degiy/stm32wb55_linky/design/adc_int.PNG

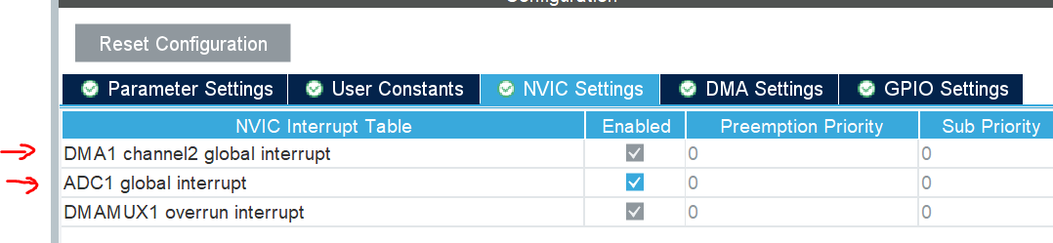
design/adc_int.PNG
