degiy/stm32wb55_linky/design/adc_settings.PNG

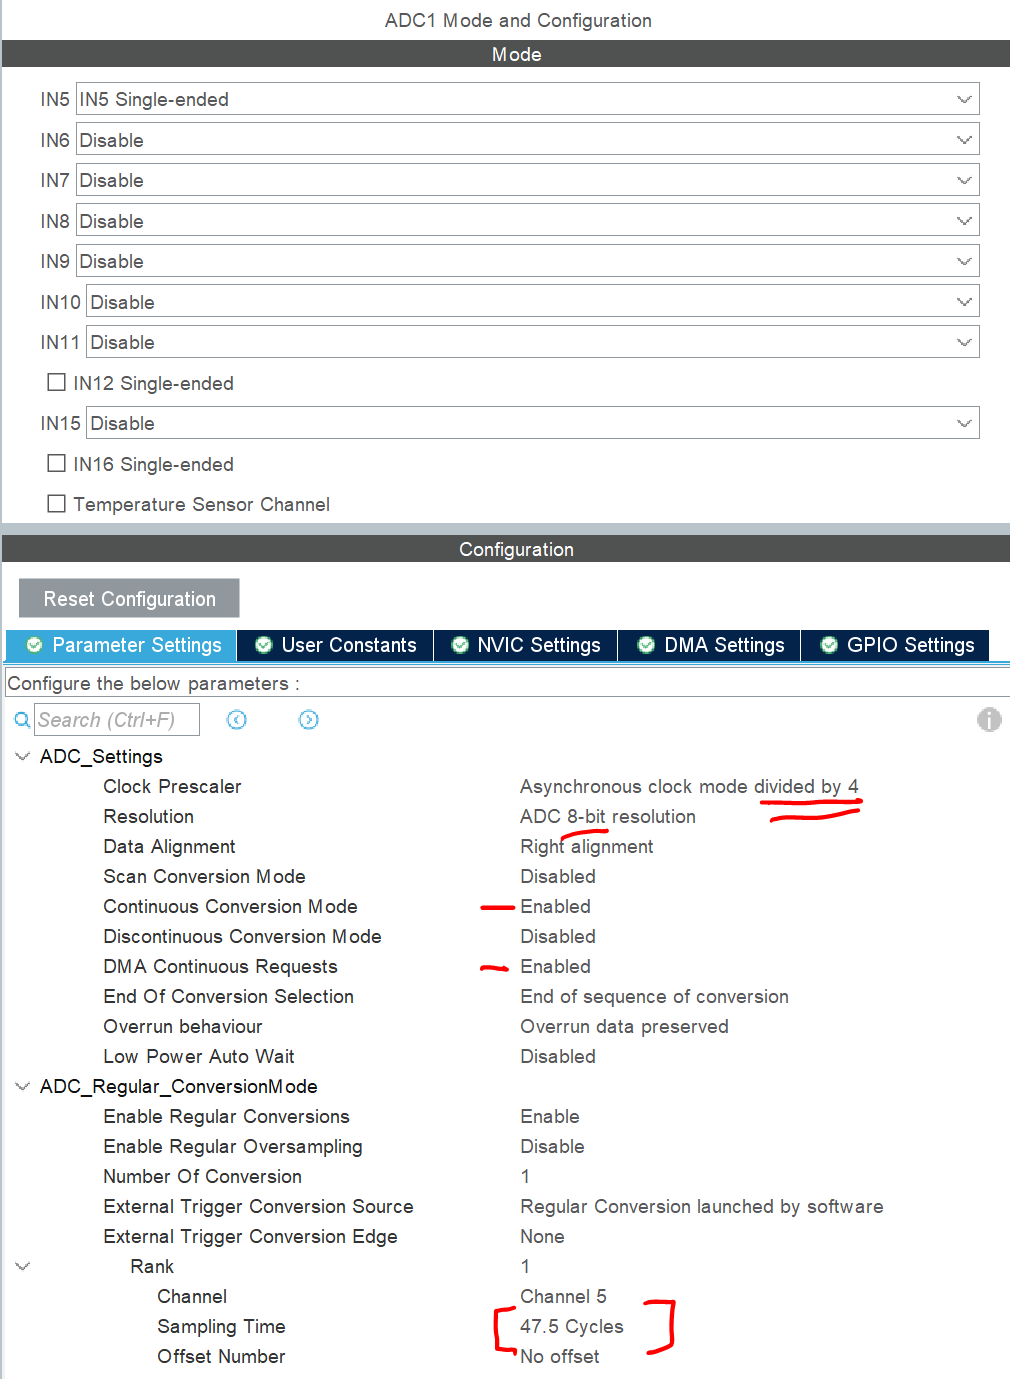
design/adc_settings.PNG
