degiy/stm32wb55_linky/design/dma.PNG

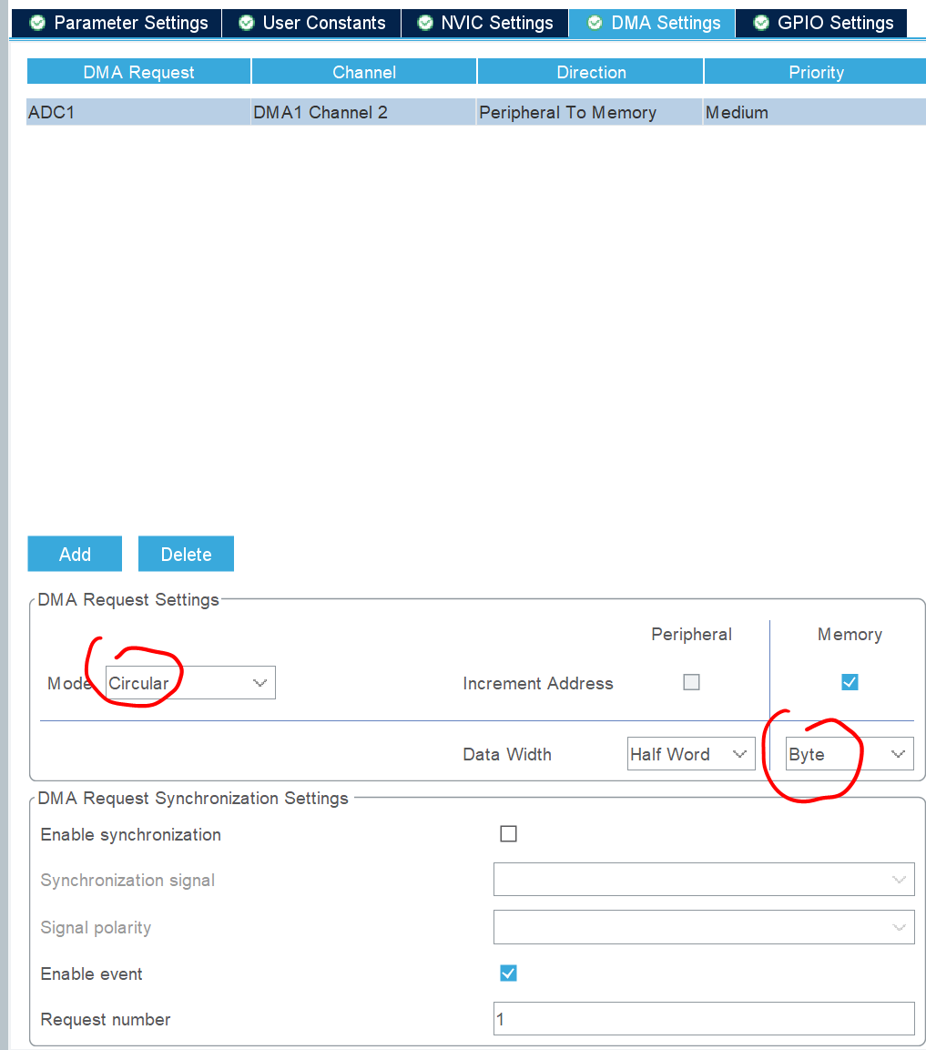
design/dma.PNG
