degiy/stm32wb55_linky/schematic/circuit.PNG

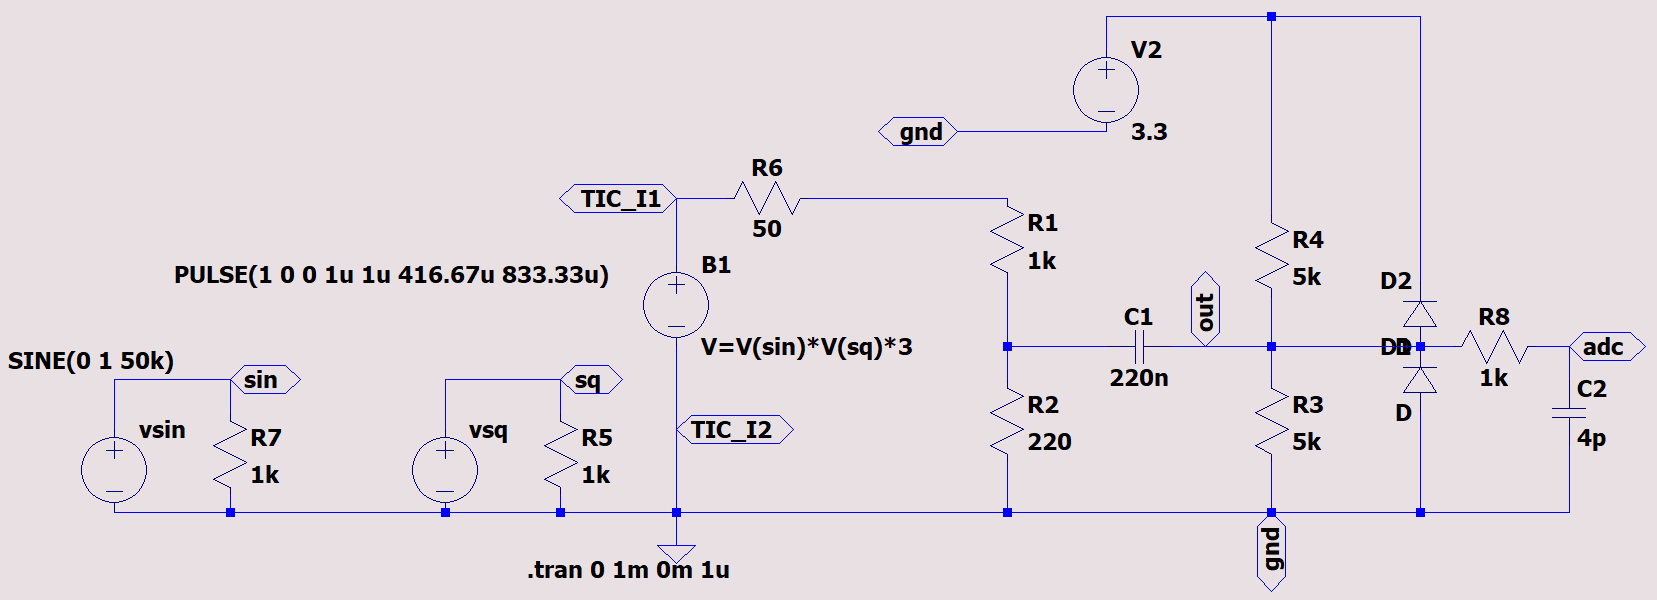
schematic/circuit.PNG
