degiy/stm32wb55_linky/schematic/pin_out.PNG

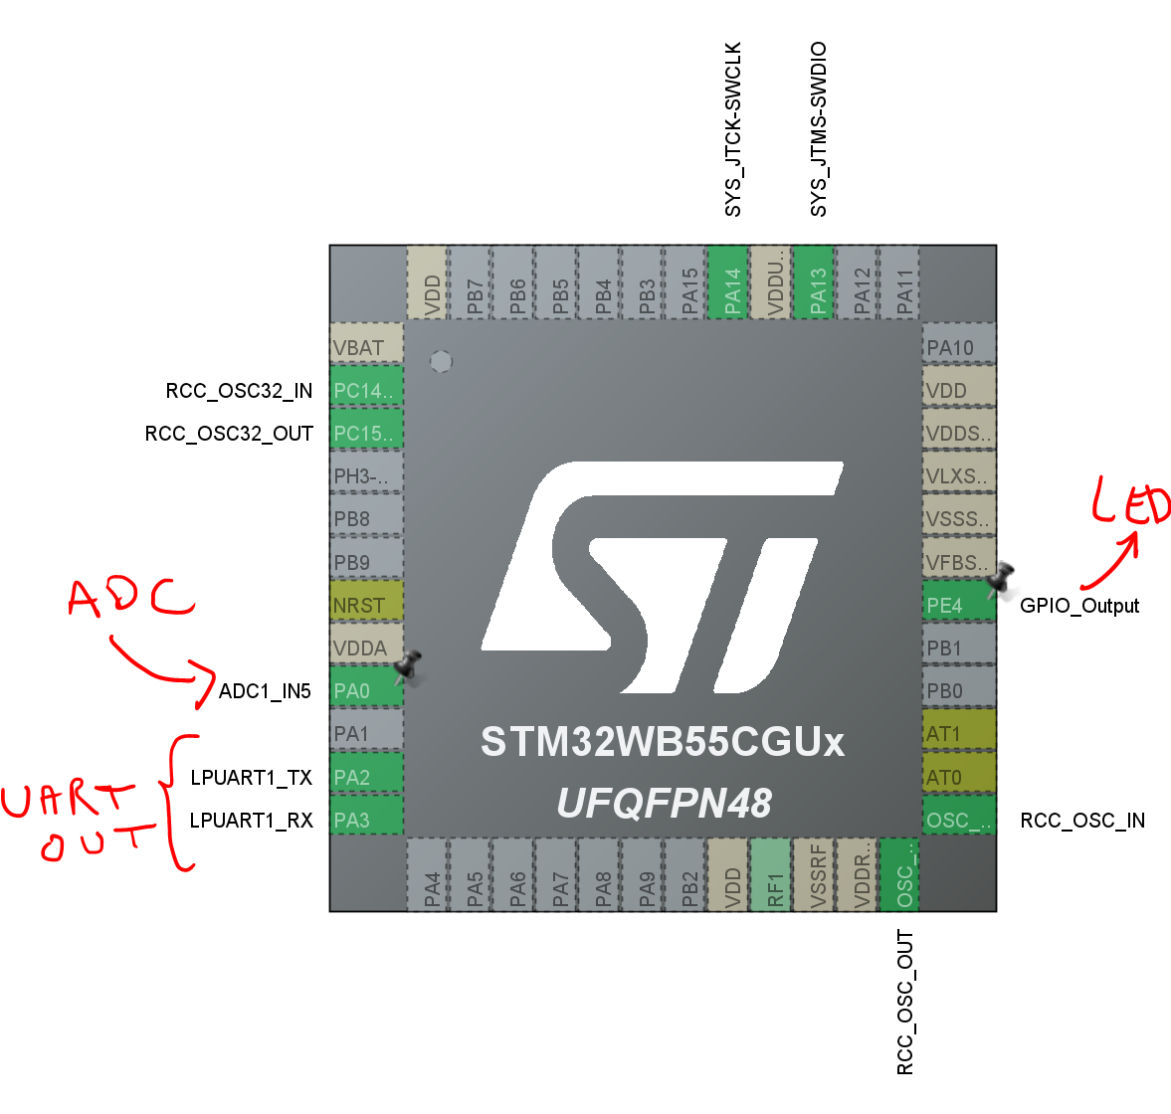
schematic/pin_out.PNG
