degiy/stm32wb55_linky/schematic/simu.PNG

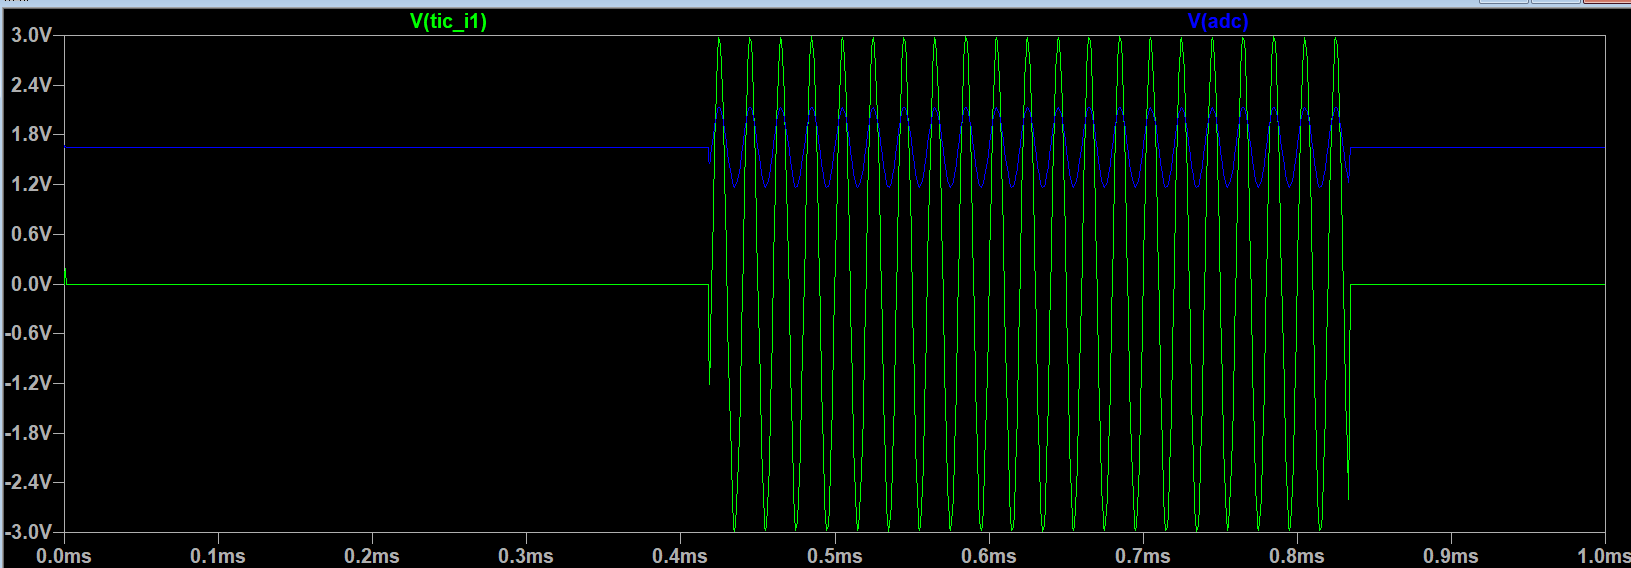
schematic/simu.PNG
