degiy/stm32wb55_linky/schematic/tic_adc.asc

B1: bv; V=V(sin)*V(sq)*3
C1: cap; 220n
C2: cap; 4p
D1: diode
D2: diode
R1: res; 1k
R2: res; 220
R3: res; 5k
R4: res; 5k
R5: res; 1k
R6: res; 50
R7: res; 1k
R8: res; 1k
V2: voltage; 3.3
vsin: voltage; SINE(0 1 50k)
vsq: voltage; PULSE(1 0 0 1u 1u 416.67u 833.33u)
Named nets: 0, gnd, out, sin, sq, adc
.tran 0 1m 0m 1u
