degiy/stm32wb55_linky/source/adc4.ioc

Mcu.UserName=STM32WB55CGUx
PA0.Signal=ADCx_IN5
PA13.Signal=SYS_JTMS-SWDIO
PA14.Signal=SYS_JTCK-SWCLK
PA2.Signal=LPUART1_TX
PA3.Signal=LPUART1_RX
PC14-OSC32_IN.Signal=RCC_OSC32_IN
PC15-OSC32_OUT.Signal=RCC_OSC32_OUT
PE4.Signal=GPIO_Output
