degiy/stm32wb55_linky/(notices)

Notices in the files:
source/main.c:
Copyright (c) 2025 STMicroelectronics.
All rights reserved.
This software is licensed under terms that can be found in the LICENSE file
